tdorssers/mePed/schematic/mePed.sch

## EAGLE design schematic/mePed.sch (2019-11-04)

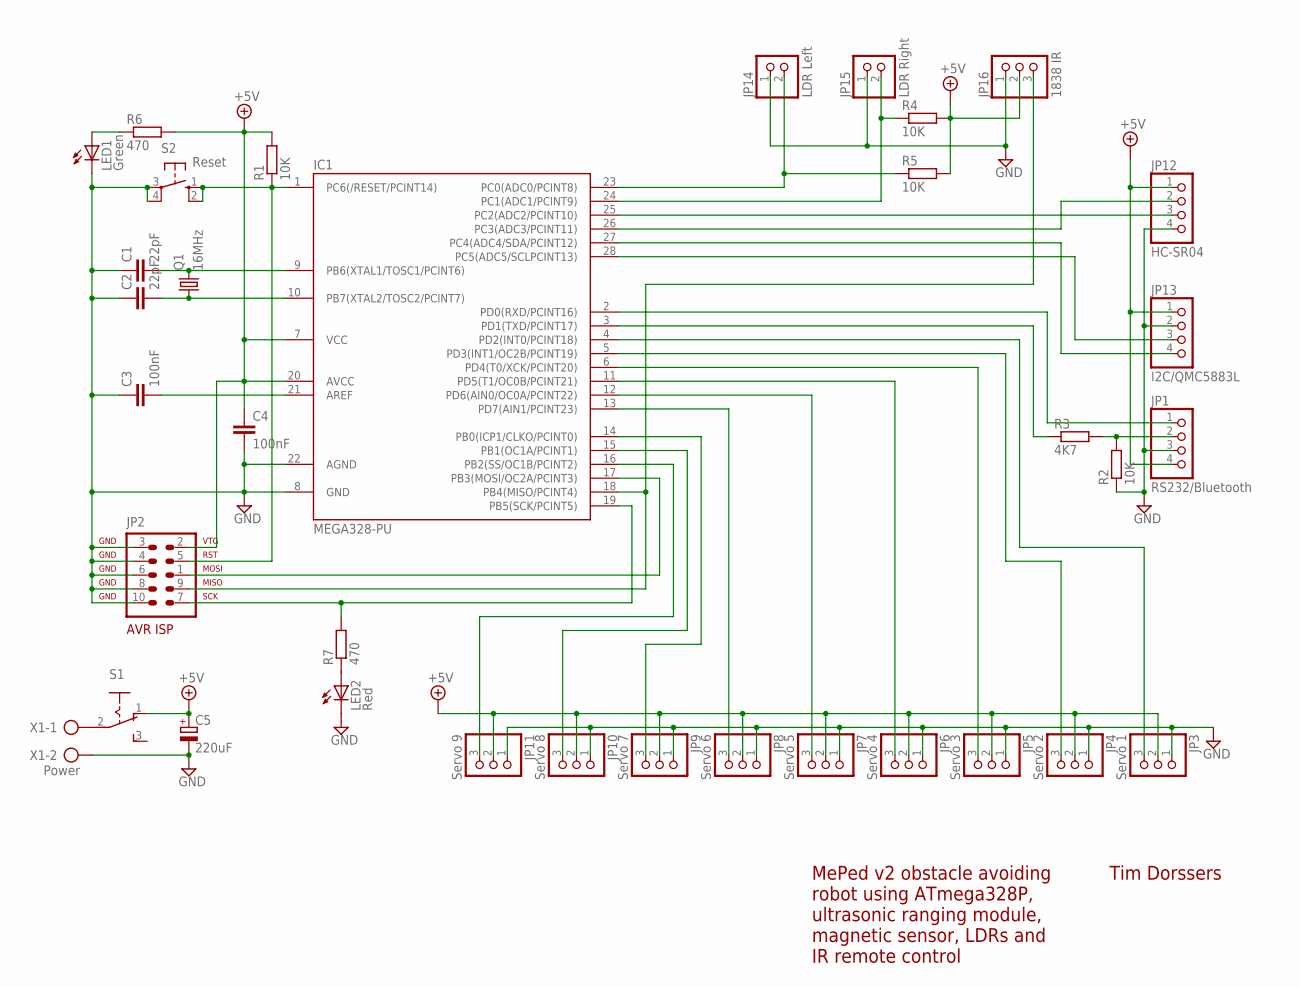
[picture p3: schematic mePed.sch]

Parts:
C1, C2: 22pF; C025-024X044
C3, C4: 100nF; C025-025X050
C5: 220uF; B45181A
IC1: MEGA328-PU; DIL28-3
JP1: RS232/Bluetooth; 1X04
JP2: AVR-ISP-10
JP3: Servo 1; 1X03
JP4: Servo 2; 1X03
JP5: Servo 3; 1X03
JP6: Servo 4; 1X03
JP7: Servo 5; 1X03
JP8: Servo 6; 1X03
JP9: Servo 7; 1X03
JP10: Servo 8; 1X03
JP11: Servo 9; 1X03
JP12: HC-SR04; 1X04
JP13: I2C/QMC5883L; 1X04
JP14: LDR Left; 1X02
JP15: LDR Right; 1X02
JP16: 1838 IR; 1X03
LED1: Green; LED5MM
LED2: Red; LED5MM
Q1: 16MHz; HC49/S
R1, R2, R4, R5: 10K; 0204/7
R3: 4K7; 0204/7
R6, R7: 470; 0204/7
S1: 255SB
S2: Reset; B3F-10XX
X1: Power; AK300/2

Connections:
+5V: C4.1, C5.+, IC1.7 (VCC), IC1.20 (AVCC), JP1.4, JP2.2, JP3.2, JP4.2, JP5.2, JP6.2, JP7.2, JP8.2, JP9.2, JP10.2, JP11.2, JP12.1, JP13.1, JP16.2, R1.2, R4.2, R5.2, R6.2, S1.1 (O)
GND: C1.1, C2.1, C3.1, C4.2, C5.-, IC1.8 (GND), IC1.22 (AGND), JP1.3, JP2.3, JP2.4, JP2.6, JP2.8, JP2.10, JP3.1, JP4.1, JP5.1, JP6.1, JP7.1, JP8.1, JP9.1, JP10.1, JP11.1, JP12.4, JP13.2, JP14.1, JP15.1, JP16.1, LED1.K (C), LED2.K (C), R2.1, S2.3, S2.4 (P1), X1.2
unnamed: IC1.23 (PC0(ADC0/PCINT8)), JP14.2, R5.1
unnamed: IC1.1 (PC6(/RESET/PCINT14)), JP2.5, R1.1, S2.1 (S), S2.2 (S1)
unnamed: IC1.24 (PC1(ADC1/PCINT9)), JP15.2, R4.1
unnamed: IC1.25 (PC2(ADC2/PCINT10)), JP12.3
unnamed: IC1.26 (PC3(ADC3/PCINT11)), JP12.2
unnamed: IC1.27 (PC4(ADC4/SDA/PCINT12)), JP13.4
unnamed: IC1.28 (PC5(ADC5/SCLPCINT13)), JP13.3
unnamed: IC1.2 (PD0(RXD/PCINT16)), JP1.1
unnamed: IC1.3 (PD1(TXD/PCINT17)), R3.1
unnamed: IC1.5 (PD3(INT1/OC2B/PCINT19)), JP4.3
unnamed: IC1.6 (PD4(T0/XCK/PCINT20)), JP5.3
unnamed: IC1.4 (PD2(INT0/PCINT18)), JP3.3
unnamed: IC1.11 (PD5(T1/OC0B/PCINT21)), JP6.3
unnamed: IC1.19 (PB5(SCK/PCINT5)), JP2.7, R7.2
unnamed: IC1.18 (PB4(MISO/PCINT4)), JP2.9, JP16.3
unnamed: IC1.17 (PB3(MOSI/OC2A/PCINT3)), JP2.1
unnamed: IC1.12 (PD6(AIN0/OC0A/PCINT22)), JP7.3
unnamed: IC1.13 (PD7(AIN1/PCINT23)), JP8.3
unnamed: IC1.16 (PB2(SS/OC1B/PCINT2)), JP11.3
unnamed: C1.2, IC1.9 (PB6(XTAL1/TOSC1/PCINT6)), Q1.2
unnamed: C2.2, IC1.10 (PB7(XTAL2/TOSC2/PCINT7)), Q1.1
unnamed: IC1.15 (PB1(OC1A/PCINT1)), JP10.3
unnamed: JP1.2, R2.2, R3.2
unnamed: C3.2, IC1.21 (AREF)
unnamed: IC1.14 (PB0(ICP1/CLKO/PCINT0)), JP9.3
unnamed: S1.2, X1.1
unnamed: LED1.A, R6.1
unnamed: LED2.A, R7.1

Notes on the sheet:
Tim Dorssers
MePed v2 obstacle avoiding robot using ATmega328P, ultrasonic ranging module, magnetic sensor, LDRs and IR remote control
